AengusXC/Rover/Images/Reference.png

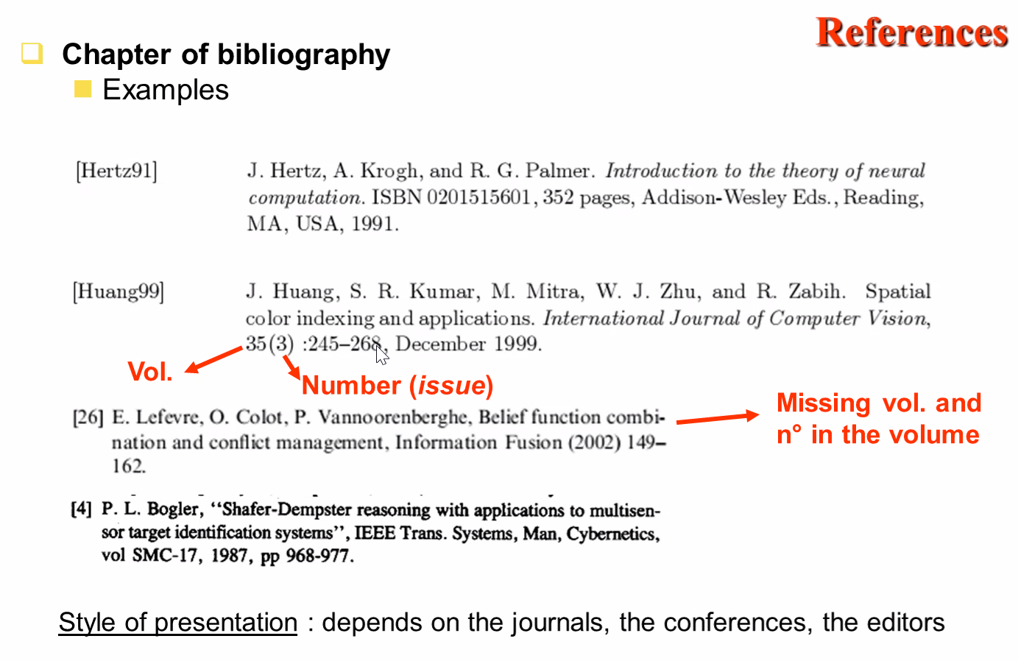
Images/Reference.png
