AengusXC/Rover/(commit log)

2021-05-14 Code for Arduino
2021-05-14 Data storage of sensor and video stream
2021-05-14 IP camera bridge for PC
2021-05-14 IP camera IP address
